aaedmusa/TOPS/Full Robot Schematic.png

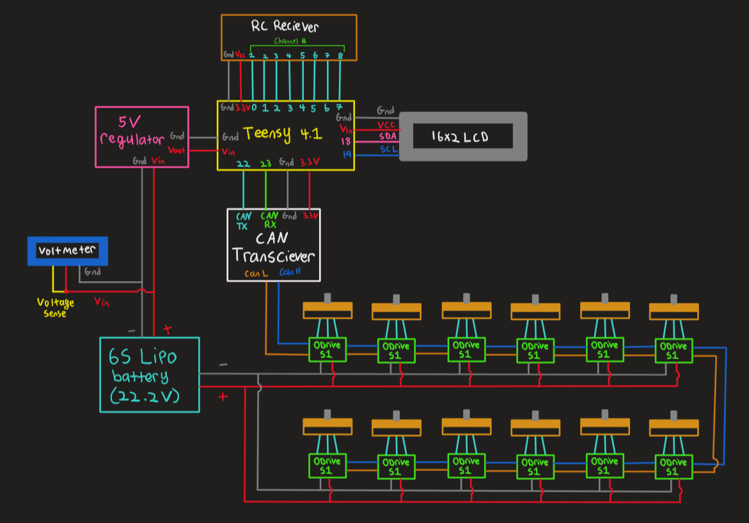
Full Robot Schematic.png
