aaedmusa/TOPS/TOPS BOM.xlsx

Sheet: Single Leg Assembly BOM
Single Leg Assembly V2 BOM |  |  |  |  | Total Screw/Insert/Nut Count
Name of Component | Price | Units Sold | Units Needed | Cost of Needed Units | M3 | Single Leg Total | Robot Total
 |  |  |  |  | 6mm insert | 28 | 112
ABAD Actuator |  |  |  |  | 6mm screws | 10 | 40
Eaglepower 8308 Brushless Motor 90KV (https://www.aliexpress.us/item/2255800377511662.html) | $61.00 | 1 | 1 | $61.00 | 8mm screws | 6 | 24
ODrive S1 (w/Screw Terminals) (https://odriverobotics.com/shop/odrive-s1) | $149.00 | 1 | 1 | $149.00 | 10mm screws | 16 | 64
⌀8 x 2.5mm Encoder Magnet (https://www.andymark.com/products/redline-encoder-magnet) | $1.50 | 1 | 1 | $1.50 | 22mm screws | 8 | 32
75x95x10mm Bearing (https://www.amazon.com/gp/product/B082PYRJ4V/ref=ppx_yo_dt_b_asin_title_o01_s00?ie=UTF8&psc=1) | $16.49 | 1 | 1 | $16.49 | M4 Screws | Single Leg Total | Robot Total
12x28x8mm Bearings (https://www.amazon.com/dp/B01K1OUR84?psc=1&ref=ppx_yo2ov_dt_b_product_details) | $9.99 | 10 | 3 | $3.00 | 12mm screws | 12 | 48
M3 x 6mm Inserts (https://www.amazon.com/uxcell-Knurled-Threaded-Insert-Embedment/dp/B07LBQRYR3?s=industrial) | $9.49 | 50 | 9 | $1.71 | 25mm screws | 2 | 8
M3 x 5mm Standoffs (https://www.amazon.com/gp/product/B07M7D9PRM/ref=ppx_yo_dt_b_search_asin_title?ie=UTF8&psc=1) | $7.99 | 10 | 4 | $3.20 | 40mm screws | 18 | 72
M3 x 6mm Screws (https://www.amazon.com/Socket-Screws-Stainless-Thread-Bright/dp/B08GLK3VZM) | $6.99 | 50 | 3 | $0.42 | 45mm screws | 4 | 16
M3 x 8mm Screws (https://www.amazon.com/Socket-Screws-Stainless-Thread-Bright/dp/B08GLLBCYV) | $8.99 | 100 | 2 | $0.18 | 70mm screws | 7 | 28
M3 x 10mm Screws (https://www.amazon.com/Fullerkreg-Socket-Stainless-Machine-Quantity/dp/B07CK3RSN3) | $7.69 | 100 | 4 | $0.31 | locknuts | 25 | 100
M3 x 22mm Screws (https://www.amazon.com/FullerKreg-M3-0-5-Alloy-Socket-Finish/dp/B07B2RFFQD) | $9.25 | 100 | 4 | $0.37
M4 Locknuts (https://www.amazon.com/gp/product/B08LMNFS5P/ref=ewc_pr_img_1?smid=A7L3QGQ9OUIWY&psc=1) | $6.59 | 50 | 7 | $0.92
M4 x 12mm Screws (https://www.amazon.com/M4-0-7X-Available-Stainless-Machine-Fastener/dp/B081JR95W2?s=industrial) | $8.49 | 100 | 4 | $0.34
M4 x 25mm Screws (https://www.amazon.com/gp/product/B081JYXLK7/ref=twister_dp_update?ie=UTF8&psc=1&redirect=true) | $7.99 | 50 | 2 | $0.32
M4 x 40mm Screws (https://www.amazon.com/dp/B089N9WMD6?ref=ppx_yo2ov_dt_b_product_details&th=1) | $8.12 | 50 | 7 | $1.14
PLA Filament | $20.00 | 1000 | 292 | $5.84
 |  |  | Subtotal | $245.73
Hip Actuator
Eaglepower 8308 Brushless Motor 90KV (https://www.aliexpress.us/item/2255800377511662.html) | $61.00 | 1 | 1 | $61.00
ODrive S1 (w/Screw Terminals) (https://odriverobotics.com/shop/odrive-s1) | $149.00 | 1 | 1 | $149.00
⌀8 x 2.5mm Encoder Magnet (https://www.andymark.com/products/redline-encoder-magnet) | $1.50 | 1 | 1 | $1.50
75x95x10mm Bearing (https://www.amazon.com/gp/product/B082PYRJ4V/ref=ppx_yo_dt_b_asin_title_o01_s00?ie=UTF8&psc=1) | $16.49 | 1 | 1 | $16.49
12x28x8mm Bearings (https://www.amazon.com/dp/B01K1OUR84?psc=1&ref=ppx_yo2ov_dt_b_product_details) | $9.99 | 10 | 4 | $4.00
M3 x 6mm Inserts (https://www.amazon.com/uxcell-Knurled-Threaded-Insert-Embedment/dp/B07LBQRYR3?s=industrial) | $9.49 | 50 | 9 | $1.71
M3 x 5mm Standoffs (https://www.amazon.com/gp/product/B07M7D9PRM/ref=ppx_yo_dt_b_search_asin_title?ie=UTF8&psc=1) | $7.99 | 10 | 4 | $3.20
M3 x 6mm Screws (https://www.amazon.com/Socket-Screws-Stainless-Thread-Bright/dp/B08GLK3VZM) | $6.99 | 50 | 3 | $0.42
M3 x 8mm Screws (https://www.amazon.com/Socket-Screws-Stainless-Thread-Bright/dp/B08GLLBCYV) | $8.99 | 100 | 2 | $0.18
M3 x 10mm Screws (https://www.amazon.com/Fullerkreg-Socket-Stainless-Machine-Quantity/dp/B07CK3RSN3) | $7.69 | 100 | 4 | $0.31
M3 x 22mm Screws (https://www.amazon.com/FullerKreg-M3-0-5-Alloy-Socket-Finish/dp/B07B2RFFQD) | $9.25 | 100 | 4 | $0.37
M4 Locknuts (https://www.amazon.com/gp/product/B08LMNFS5P/ref=ewc_pr_img_1?smid=A7L3QGQ9OUIWY&psc=1) | $6.59 | 50 | 13 | $1.71
M4 x 12mm Screws (https://www.amazon.com/M4-0-7X-Available-Stainless-Machine-Fastener/dp/B081JR95W2?s=industrial) | $8.49 | 100 | 4 | $0.34
M4 x 40mm Screws (https://www.amazon.com/dp/B089N9WMD6?ref=ppx_yo2ov_dt_b_product_details&th=1) | $8.12 | 50 | 9 | $1.46
PLA Filament | $20.00 | 1000 | 281 | $5.62
 |  |  | Subtotal | $247.30
Knee Actuator
Eaglepower 8308 Brushless Motor 90KV (https://www.aliexpress.us/item/2255800377511662.html) | $61.00 | 1 | 1 | $61.00
ODrive S1 (w/Screw Terminals) (https://odriverobotics.com/shop/odrive-s1) | $149.00 | 1 | 1 | $149.00
⌀8 x 2.5mm Encoder Magnet (https://www.andymark.com/products/redline-encoder-magnet) | $1.50 | 1 | 1 | $1.50
M3 x 6mm Inserts (https://www.amazon.com/uxcell-Knurled-Threaded-Insert-Embedment/dp/B07LBQRYR3?s=industrial) | $9.49 | 50 | 6 | $1.14
M3 x 5mm Standoffs (https://www.amazon.com/gp/product/B07M7D9PRM/ref=ppx_yo_dt_b_search_asin_title?ie=UTF8&psc=1) | $7.99 | 10 | 4 | $3.20
M3 x 6mm Screws (https://www.amazon.com/Socket-Screws-Stainless-Thread-Bright/dp/B08GLK3VZM) | $6.99 | 50 | 4 | $0.56
M3 x 8mm Screws (https://www.amazon.com/Socket-Screws-Stainless-Thread-Bright/dp/B08GLLBCYV) | $8.99 | 100 | 2 | $0.18
M3 x 10mm Screws (https://www.amazon.com/Fullerkreg-Socket-Stainless-Machine-Quantity/dp/B07CK3RSN3) | $7.69 | 100 | 4 | $0.31
M4 x 12mm Screws (https://www.amazon.com/M4-0-7X-Available-Stainless-Machine-Fastener/dp/B081JR95W2?s=industrial) | $8.49 | 100 | 4 | $0.34
M4 x 40mm Screws (https://www.amazon.com/dp/B089N9WMD6?ref=ppx_yo2ov_dt_b_product_details&th=1) | $8.12 | 50 | 2 | $0.32
PLA Filament | $20.00 | 1000 | 171 | $3.42
 |  |  | Subtotal | $220.97
General Parts
26mmOD x 24mmID Carbon Fiber Tube (https://www.amazon.com/dp/B09WZZQ7Q9?psc=1&ref=ppx_yo2ov_dt_b_product_details) | $29.98 | 1000 | 130 | $3.90
300mm HTD Timing Belt (https://www.amazon.com/dp/B077ZDS1TM?psc=1&ref=ppx_yo2ov_dt_b_product_details) | $15.19 | 2 | 2 | $15.19
20x32x7mm Bearings (https://www.amazon.com/gp/product/B07TJFK68V/ref=ppx_yo_dt_b_search_asin_title?ie=UTF8&psc=1) | $8.99 | 5 | 2 | $3.60
12x28x8mm Bearings (https://www.amazon.com/dp/B01K1OUR84?psc=1&ref=ppx_yo2ov_dt_b_product_details) | $9.99 | 10 | 2 | $2.00
M3 x 10mm Screws (https://www.amazon.com/Fullerkreg-Socket-Stainless-Machine-Quantity/dp/B07CK3RSN3) | $7.69 | 4 | 4 | $7.69
M3 x 6mm Inserts (https://www.amazon.com/uxcell-Knurled-Threaded-Insert-Embedment/dp/B07LBQRYR3?s=industrial) | $9.49 | 50 | 4 | $0.76
M4 Locknuts (https://www.amazon.com/gp/product/B08LMNFS5P/ref=ewc_pr_img_1?smid=A7L3QGQ9OUIWY&psc=1) | $6.99 | 50 | 5 | $0.70
M4 x 45mm Screws (https://www.amazon.com/gp/product/B09HQK69XB/ref=twister_dp_update?ie=UTF8&redirect=true&th=1) | $9.09 | 30 | 4 | $1.21
M4 x 70mm Screws (https://www.amazon.com/M4-0-7-Button-Stainless-Machine-Hexagon/dp/B09HQLK49X?sp_csd=d2lkZ2V0TmFtZT1zcF9hdGY) | $9.99 | 20 | 7 | $3.50
PLA Filament | $20.00 | 1000 | 246 | $4.92
 |  |  | Subtotal | $43.46
 |  |  | Total | $757.45

Sheet: Robot Assembly BOM
Robot Assembly BOM
Name of Component | Price | Units Sold | Units Needed | Cost of Needed Units
Electronics
Leg Assembly | $757.45 | 1 | 4 | $3029.80
Teensy 4.1 Microcontroller | $35.38 | 1 | 1 | $35.38
6S 5200mAh 60C Lipo Battery (https://www.amazon.com/gp/product/B07MMM31CH/ref=ppx_yo_dt_b_search_asin_title?ie=UTF8&th=1) | $69.99 | 1 | 1 | $69.99
16x2 LCD Screen (https://www.amazon.com/dp/B0BWTFN9WF?psc=1&ref=ppx_yo2ov_dt_b_product_details) | $10.99 | 3 | 1 | $3.66
SPST Switch (https://www.amazon.com/gp/product/B01N2U8PK0/ref=ppx_yo_dt_b_search_asin_title?ie=UTF8&psc=1) | $6.99 | 16 | 1 | $0.44
5V Regulator (https://www.amazon.com/gp/product/B076P4C42B/ref=ppx_yo_dt_b_search_asin_title?ie=UTF8&psc=1) | $12.89 | 4 | 1 | $3.22
Voltage Display (https://www.amazon.com/dp/B072BY4XZ7?psc=1&ref=ppx_yo2ov_dt_b_product_details) | $9.89 | 2 | 1 | $4.95
RC Transmitter and Reciever (https://www.amazon.com/gp/product/B07WR9Y1HG/ref=ppx_yo_dt_b_search_asin_title?ie=UTF8&th=1) | $54.99 | 1 | 1 | $54.99
USB Isolator (https://www.andymark.com/products/redline-encoder-magnet) | $14.99 | 1 | 1 | $14.99
XT60H Connectors | $7.99 | 12 | 5 | $3.33
22 AWG Wire (https://www.amazon.com/dp/B07K9R9LBV?psc=1&ref=ppx_yo2ov_dt_b_product_details) | $16.98 | 1 | 0.25 | $4.25
14 AWG Wire (https://www.amazon.com/dp/B09GJLGHM6?ref=ppx_yo2ov_dt_b_product_details&th=1) | $20.99 | 1 | 0.25 | $5.25
 |  |  | Subtotal | $3230.24
General parts
26mmOD x 24mmID x 500mm Carbon Fiber Tube (https://www.amazon.com/dp/B09WZZQ7Q9?psc=1&ref=ppx_yo2ov_dt_b_product_details) | $29.98 | 1000 | 2000 | $59.96
30A Silicone A-B mix (https://www.amazon.com/dp/B08CVSD6MZ?psc=1&ref=ppx_yo2ov_dt_b_product_details) | $27.69 | 1 | 1 | $27.69
PLA Filament | $20.00 | 1000 | 569 | $11.38
 |  |  | Subtotal | $99.03
 |  |  | Total | $3329.27
