aaedmusa/TOPS/(threads)

Thread 3 (2025-07-05):

The BOM.xlsx file is corrupted.

scattercat-123, 2025-07-05:
When i open the bom it doesnt show anything. i just was wondering how much diameter carbon fiber rod did you put because i was making my own inspired by you!

aaedmusa, 2025-07-05:
I just checked the BOM file, and it looks fine. Try downloading it again.

scattercat-123, 2025-07-05:
dam fast reply.. idk for me its corrupted..

scattercat-123, 2025-07-05:
its okay maybe il just use 25mm diameter carbon rods

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
